danielbernalb/LibreCO2/images/Box 1.jpg

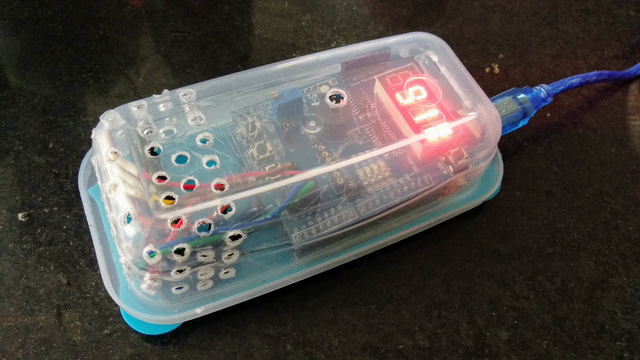
images/Box 1.jpg
