danielbernalb/LibreCO2/images/Sensirion SCD30 connection.jpg

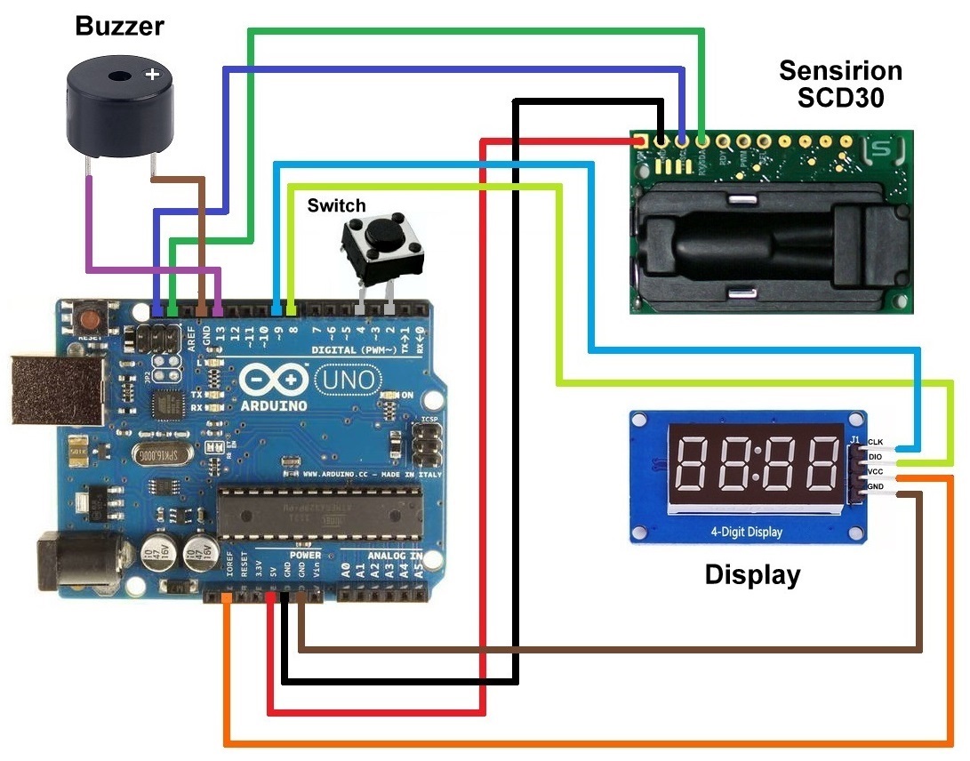
images/Sensirion SCD30 connection.jpg
