danielbernalb/LibreCO2/images/ShieldMF.jpg

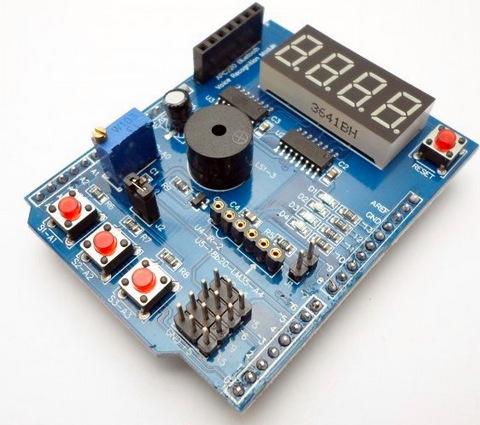
images/ShieldMF.jpg
