danielbernalb/LibreCO2/images/Materiales2.jpg

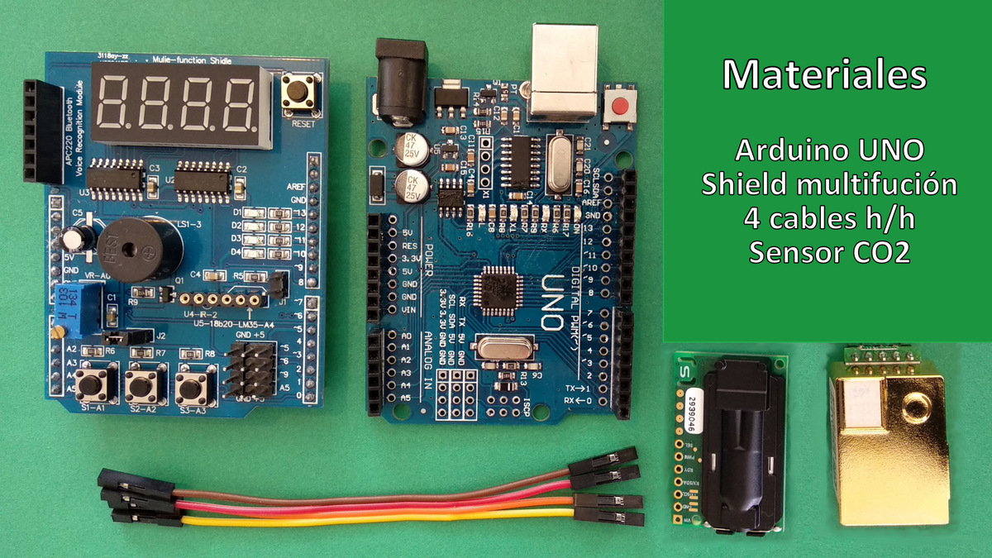
images/Materiales2.jpg
