danielbernalb/LibreCO2/images/Materials all.jpg

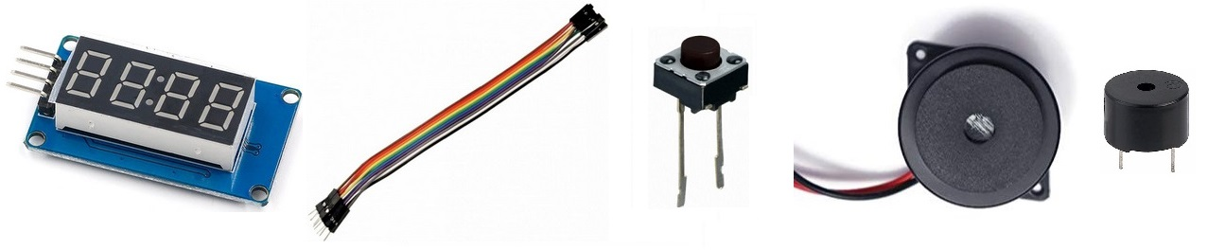
images/Materials all.jpg
