danielbernalb/LibreCO2/INSTRUCCIONES en Español.md

# LibreCO2
LibreCO2: Medidor de CO2 usando Arduino UNO y un sensor de CO2 comercial (SenseAir S8, Sensirion SCD30, Winsen MH-Z14 o MHZ-19 o Cubic CM1106).

Esta es una versión básica de un medidor de CO2 de bajo costo con los materiales más comunes del mercado: Arduino UNO y los 4 sensores de bajo costo de CO2 más populares: SenseAir S8, Sensirion SCD30, Winsen MH-Z14 o 19 y Cubic CM1106. LibreCO2 usa un Arduino UNO, pero puede extenderse al MEGA o nano, por ser muy popular en escuelas y frecuentemente usado en las clases de tecnología o electrónica y la mayoría de escuelas tienen muchos de ellos. 

El código del Arduino es lo más sencillo posible y puede programarse cargando el archivo .hex con el programa Xloader y así no necesitarías instalar el software Arduino para compilar y programar el código. Si buscas un sensor más avanzado y con conectividad por Bluetooth o por Wifi puedes construir un [AireCiudadano](https://github.com/danielbernalb/AireCiudadano) con conectividad Bluetooth y Wifi. LibreCO2 usa los componentes más populares del mercado, así no sean los más avanzados, y el armado más sencillo posible sin necesitar el uso de cautín y soldadura de estaño.

Todos los sensores usados aquí son NDIR que es el estándar actuales para mediciones reales de CO2: 

https://www.co2meter.com/blogs/news/6010192-how-does-an-ndir-co2-sensor-work

Además se ha agregado la compensación de la altura sobre el nivel del mar a la que tomamos la medición.
Es muy importante activar este ajuste por encima de los 1000 metros pues el margen de error sería superior al 11%:

| Altura | Error(%) |
|---|---|
| 0 | 0 |
|  500 | 6 |
|  1000  | 11 |
|  1500  | 16 |
|  2000  | 21 |
|  2500  | 26 |
|  3000  | 30 |
|  3500  | 34 |

# 1. Materiales:

Existen dos opciones para el armado de sensor, la más sencilla es usando un Escudo Multifunción (Shield) de Arduino el cual ya incluye el Display de 4 dígitos, el buzzer y los botones, con lo cual se facilita mucho más el montaje. La segunda armando las partes por individual.

# 1.1. Opción con Escudo multifunción:

Materiales

1. Escudo multifunción (Arduino Shield multifunction).

El Escudo tiene un bug o error que puede cortocircuitarlo con el conector USB, corte los pines que se muestran en la foto y agregue un trozo de cinta al conector USB (que también se muestra en el [video explicativo](https://github.com/danielbernalb/LibreCO2/blob/main/INSTRUCCIONES%20en%20Espa%C3%B1ol.md#video-explicativo):

Cortar pines escudo

Link compra [Aliexpress](https://es.aliexpress.com/wholesale?SearchText=multifunction-arduino-shield), Link compra [Colombia](https://listado.mercadolibre.com.co/arduino-escudo-multi-funcion#D[A:arduino%20escudo%20multi%20funcion]), Compra Latinoamérica: Mercadolibre o tiendas de electrónica.

2. Arduino UNO cualquier versión. Sirve el original Arduino Italiano o las versiones chinas, la diferencia está en la instalación del driver. El que llaman "Original" a la izquierda y la copia o clone a la derecha:

Arduino original & clone

Link compra [Aliexpress](https://es.aliexpress.com/wholesale?catId=0&initiative_id=SB_20210322194538&SearchText=arduino+uno+r3), Link compra [Colombia](https://listado.mercadolibre.com.co/arduino-uno#D[A:arduino%20uno]), Compra Latinoamérica: Mercadolibre o tiendas de electrónica.

3. 4 cables jumper hembra hembra (sirve cualquier tamaño pero es preferible 10 o 15cm).

Link compra [Aliexpress](https://es.aliexpress.com/wholesale?SearchText=jumper-wires), Link compra [Colombia](https://listado.mercadolibre.com.co/arduino-jumper-hembre-hembra#D[A:arduino%20jumper%20hembre%20hembra]), Compra Latinoamérica: Mercadolibre o tiendas de electrónica.

4. Sensor, opciones:

	a. SenseAir S8, el mejor en relación costo/beneficio. Traído desde China por Aliexpress cuesta 28 dólares y desde USA 44 dólares, es el más recomendado y su costo es bajo. Además tiene el referente de ser la misma marca de sensor que usa los populares medidores Aranet 4 de 200 euros de precio (https://kaspars.net/blog/aranet4-teardown).
	
	SenseAir S8
	
	Link desde Aliexpress China:
	https://es.aliexpress.com/item/4000884582128.html
	
	Link desde Digikey USA:
	https://www.digikey.com/es/products/detail/senseair-north-america-inc/004-0-0053/10416532
	
	A favor: excelente precio, muy buen desempeño (aceptable velocidad y fiel), rápido envío desde USA y envío gratis desde China.
	
	En contra: necesita soldadura para conectar los pines o cables. 
	
	b. Sensirion SCD30, el más costoso (52 dólares) pero en nuestras pruebas el de mejor desempeño. Sensirion tiene distribuidores en USA y Europa que envían a Latinoamérica. Ejemplo:
	https://www.mouser.com/ProductDetail/Sensirion/SCD30/?qs=rrS6PyfT74fdywu4FxpYjQ%3D%3D
	
	SCD30 Sensirion
	
	A favor: excelente desempeño (rápido y fiel), rápido envío en USA y Europa y envíos a Latinoamérica.
	
	En contra: necesita soldadura para conectar los pines o cables, alto precio (52 dólares). 
	
	Para la conexión del Arduino al sensor Sensirion se usa el protocolo Modbus ya que este nos permite conectar directamente el Arduino al SCD30 sin necesidad de drivers de datos que complicarían mucho el montaje. Sólo debes conectar el pin SEL al VIN del sensor usando una resistencia de 100 kΩ (kilo ohmnios) como se vé en las fotos y video para habilitar el modo Modbus.

	c. Winsen MH-Z14 o 19, el más barato y popular, buen desempeño, algo lento. Puedes usar cualquie versión de sensor: MH-Z14, MH-Z14A, MH-Z19B o MH-Z19C.b Ten cuidado con las falsas copias del sensor!!!

	Winsen MH-Z14a
	
	A favor: desempeño aceptable (lento comparado al Sensirion, fiabilidad media), bajo costo (18 dolares con envío incluido desde China por Aliexpress).
	
	En contra: tiempo de envío variable con Aliexpress desde China (20 días a mes y medio), falsificaciones (ten cuidado, sólo compra de la tienda Oficial de Aliexpress).

	REPITO: sólo compra el MH-Z19B o MH-Z19C de la tienda de distribución de Winsen en Aliexpress, el mercado está invadido de falsas copias, más información en: https://emariete.com/sensores-co2-mh-z19b-falsos/ o en ingles en: https://youtu.be/5_QQe75-SZI

	Original Winsen MH-Z19b

	Venta de versiones originales en la página del fabricante en Aliexpress:
	https://es.aliexpress.com/item/1005001865093513.html

	d. Cubic CM1106, la última opción porque el distribuidor de China vende sólo unidades recuperadas de segunda mano y de vez en cuando están agotados, son muy baratos y su desempeño es aceptable. 
	https://www.aliexpress.com/item/4001082699057.html
	
	Cubic CM1106
	
****************************

**Conexiones para cada sensor:**

PIN del Escudo ---> Sensor

**SenseAir S8 sensor**

GND ---> G0 Pin 2 de la regleta de 4 pines

+5 &nbsp; ---> G+ Pin 1 de la regleta de 4 pines

5 &nbsp; &nbsp; ---> Pin 2 de la regleta de 5 pines

6 &nbsp; &nbsp; ---> Pin 3 de la regleta de 5 pines

SenseAir S8

****************************

**Sensor Sensirion SCD30**

GND ---> GND

+5 &nbsp;  ---> VIN

5 &nbsp; &nbsp; ---> RX/SDA

6 &nbsp; &nbsp; ---> TX/SCL

SCD30 connection

****************************
**Sensor Winsen MH-Z19B o 19C**

GND ---> GND

+5 &nbsp; ---> VIN

5 &nbsp; &nbsp; ---> RX

6 &nbsp; &nbsp; ---> TX

MH-Z19B connection

****************************
**Sensor Winsen MH-Z14 o MH-Z14A**

GND ---> Pin 5 or 16 del conector

+5 &nbsp; ---> Pin 4 o 17 del conector

5 &nbsp; &nbsp; ---> Pin 3 o 18 del conector

6 &nbsp; &nbsp; ---> Pin 2 o 19 del conector

MH-Z14A connection	

****************************
**Sensor Cubic CM1106**

GND ---> G Pin 2 de la regleta de 4 pines

+5 &nbsp; ---> V1 Pin 1 de la regleta de 4 pines

5 &nbsp; &nbsp; ---> R Pin 2 de la regleta de 5 pines

6 &nbsp; &nbsp; ---> T Pin 3 de la regleta de 5 pines

Cubic CM1106

## Video explicativo:

(http://www.youtube.com/watch?v=KYHC06xhUu4 "VideoLibreCO2")

# 1.2. Opción por partes individuales:

1. Arduino UNO original o versión china.
2. Display TM1687.
3. Jumper hembra - macho.
4. Uno o dos Pulsadores o cables (uno para la calibración, otro para el nivel de Beep).
5. Opcional: Buzzer.

Materiales

6. Sensor, iguales opciones que la opción con Escudo multifunción.

****************************

**Conexiones para todos los sensores:**

Componente electrónico ---> PIN del Arduino

**Display---> PIN Arduino**

CLK    ---> 9

DIO    ---> 8

VCC    ---> IOREF en la versión original o 5V en la copia china

GND    ---> GND

**Buzzer**

"+"    ---> 11

otro  ---> GND

**Pulsador de calibración**

Cualquiera ---> A0

Cualquiera ---> A2

**Pulsador de nivel del Beep**

Cualquiera ---> A3

Cualquiera ---> A5

**Pulsador de altura sobre el nivel del mar**

Cualquiera ---> 2

Cualquiera ---> 4

****************************
**SenseAir S8**

VIN Pin 1 de regleta de 4 pines ---> 5V 

GND Pin 2 de regleta de 4 pines ---> GND

RX Pin 2 de regleta de 5 pines ---> 6

TX Pin 3 de regleta de 5 pines ---> 7 

SenseAir S8 connection

****************************
**Sensor Sensirion SCD30**

VIN    ---> 3.3V 

GND    ---> GND

TX/SCL ---> 7

RX/SDA ---> 6

SEL    ---> 3.3V

SCD30 connection

****************************
**Winsen MH-Z19B sensor**

VIN Pin 1 de regleta de 4 pines ---> 5V 

GND Pin 2 de regleta de 4 pines ---> GND

RX Pin 2 de regleta de 5 pines ---> 6

TX Pin 3 de regleta de 5 pines ---> 7 

MH-Z19B connection

****************************
**Winsen MH-Z14A sensor**

Pin 2 o 19 del conector ---> 6

Pin 3 o 18 del conector ---> 7

Pin 4 o 17 del conector ---> 5V

Pin 5 or 16 del conector ---> GND 

MH-Z14A connection	

****************************
**Cubic CM1106 sensor**

V1 Pin 1 de la regleta de 4 pines ---> 5V 

G Pin 2 de la regleta de 4 pines ---> GND

R Pin 2 de la regleta de 5 pines ---> 6

T Pin 3 de la regleta de 5 pines ---> 7 

Cubic CM1106

****************************
# 2. Programar el Firmware (código en el Arduino)

Existen 3 opciones para programar el Arduino: la más sencilla es usar un teléfono Android y un cable USB OTG, la siguiente es usar un PC con el software Xloader y la última instalando Arduino en un PC.

**1. Teléfono Android.**

USB OTG cable

 - Conecta el cable USB OTG al teléfono.
 - Instala la app de Android ["Arduino Hex Uploader-Firmware Bin Upload"](https://play.google.com/store/apps/details?id=xyz.vidieukhien.embedded.arduinohexupload&hl=en_US&gl=US).
 - Baja el archivo .hex file de este ["Directorio de Google drive"](https://drive.google.com/drive/folders/1FxXLVhaGF6UCVObQlh8cVLddyWyQqUT0) basado en la versión de tu sensor (Shield y marca de sensor). Encuentra el archivo .hex que vas cargar en el Arduino, cada versión de sensor (Sensirion, Winsen or Cubic) se encuentra disponible el el directorio "hex files". Ejemplo: "LibreCO2_MFShield_SCD30.hex" es el arhivo para el sensor Sensirion con el Shield Multifunción. Nota: No descargues el archivo .hex directamente de la página con la opción "Salvar como", que daña el archivo. Usa solamente el enlace de Google Drive.
 - Busca el archivo .hex en tú teléfono.
 - Sube el código a tu tarjeta Arduino.
 - FIN.

Video de programación de el Firmware:

(http://www.youtube.com/watch?v=_87qzZFMgwg "LibreCO2")

Link compra Cable OTG USB [Aliexpress](https://es.aliexpress.com/wholesale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), Link compra [Colombia](https://listado.mercadolibre.com.co/cable-otg#D[A:cable%20otg]), Compra Latinoamérica: Mercadolibre o tiendas de electrónica.

**2. Usando tu PC con el software Xloader (sólo Windows):**

1. Conecta el Arduino a tu computador y espera a que el driver se instale automáticamente. Si el driver no se instala automáticamente debes identificar si tu Arduino es original o una copia:

1.1. Si el Arduino es original, instala el paquete Arduino con drivers: https://www.arduino.cc/en/Guide/ArduinoUno

1.2. Si el Arduino es copia china sigue las instrucciones de esta página web: https://learn.sparkfun.com/tutorials/how-to-install-ch340-drivers

2. Después de instalado el driver, tienes 2 opciones:

2.1. Si lo único que quieres es programar el Arduino desde Windows sin tener que ver el código y compilarlo, usa el software Xloader que se encuentra en la carpeta del mismo nombre:

Xloader

A la izquierda se muestra la ventana del Xloader cuando se inicia.

2.1.1. Explora hasta encontrar el achivo .hex que vas a cargar en el Arduino. Cada versión de sensor (Sensirion, Winsen o Cubic) se encuentra disponible en el directorio "hex files". Ejemplo: "LibreCO2_Shield_SCD30.hex" es el archivo para el sensor Sensirion SCD30 con el uso del Escudo Multifunción (Shield). No lo descargues directamente de la página con la opción "Guardar como", eso arruina el archivo.  Usa el siguiente enlace de Google Drive para bajar el archivo .hex buscando tu versión de Sensor (SCD30, MHZ14_9 o CM1106) y construcción (con Shield o por Partes):
 
https://drive.google.com/drive/folders/1FxXLVhaGF6UCVObQlh8cVLddyWyQqUT0

2.1.2. Selecciona la tarjeta Arduino que estas usando (Uno/ATmega328).

2.1.3. Selecciona el puerto de comunicaciones COM al que está conectado el Arduino, si no lo sabes buscalo en el Admnistrador de dispositivos "Puertos COM y LPT".

2.1.4. Selecciona la velocidad Baud rate a 115200.

2.1.5. Presiona el botón “Upload”.

2.1.6. Cuando el archivo .hex file se carga en el Arduino, foto a la derecha, sale el mensaje de "xxxxx bytes uploaded", si falla te saldrá el mensaje de "upload fails".

**3. Si quieres editar y compilar el código instala el software Arduino en Windows, Mac o Linux:**
  
  https://www.arduino.cc/en/software
  
  La siguiente guía explica como instalar Arduino en Windows, Mac o Linux y es muy completa:
  https://learn.sparkfun.com/tutorials/installing-arduino-ide/all  
  
  En Youtube existen cientos de tutoriales para instalar Arduino en diferentes sistemas operativos y aprender su programación, además puedes colaborar mejorando este código o crear tu propia versión.  
  
 # 3. Caja para el sensor.
 
Opciones iniciando por la más sencilla y económica:

3.1. Caja comercial de bajo costo.

Busca una caja plástica con un ancho similar al del Arduino y un largo mayor para que en el espacio sobrante ubiques el sensor. En el espacio sobrante perfora varios huecos por dónde entre aire para el mismo, en mi caso los hice con destornillador de 4mm. Haz otro hueco para el Buzzer, para el cable USB y el adaptador y listo. Ejemplo:

Caja1

Cuando quieras usar el teclado para la calibración o la programación del BEEP, abre la caja y accede al teclado para luego volver a cerrala.
Puedes acomodar cajas plásticas de diferentes tamaños, en el siguiente caso se usa una espuma debajo porque la caja es más alta, además se hacen 3 huecos de un tamaño mediano (7mm) para los 3 botones y asó poder acceder desde afuera a los botones sin necesidad de abrir la caja:

Caja2

3.2. Caja en madera MDF usando corte láser. En desarrollo.

3.3. Caja en PLA con impresora 3D. En desarrollo.
  
 # 4. Funcionamiento del sensor.
 
 Cuando se haya realizado la programación del Arduino tenemos varios modos y opciones de funcionamiento del sensor:
 
 1. Modo normal: Al encender el sensor aparece el aviso BEEP y un número entre 700 y 1300 que muestra el nivel de la alarma que tenemos programado. En el numeral 3 se explicará cómo modificarlo. Luego de ello el medidor verifica la conexión al sensor de bajo costo. Si aparece el mensaje "good" la conexión está bien hecha y se continuará con el proceso de calentamiento del sensor ("heat") que dura 30 segundos para los sensores Sensirion y Cubic, y 3 minutos para los Winsen. Si el mensaje es "fail" la conexión ha fallado y debemos verificar la conexión entre el Arduino y el sensor. Después de el calentamiento el valor de CO2 en partes por millón ppm, aparece en pantalla. Cuando el valor es superior al nivel Beep la alarma suena y los leds del escudo titilan.

 2. CALI Modo Calibración: [Explicado en el video anexo](#video-explicativo).
La calibración del sensor se recomienda después de armado el sensor y cuando se aprecien mediciones muy diferentes al aire libre del rango estimado de 400 ppm. Todos estos sensores de bajo costo se calibran al aire libre, colocándolos en un espacio exterior por unos minutos sin que reciban viento fuerte pues esto afecta la medición, por ello se recomienda colocarlos dentro de una caja que evite el viento directo.
Luego de cumplir con estas condiciones, debes presionar el botón S1-A1 (CALI) en la versión con escudo, o el "switch" en la versión por partes, durante más de 5 segundos, y aparecerá en pantalla el mensaje "cal-" y comenzando un conteo regresivo de 5 minutos para el Sensirion y Cubic y 20 minutos para el Winsen.
Al finalizar este tiempo el sensor recibe la orden de calibración y queda listo para usarse de nuevo. Si quieres interrumpir el proceso de calibración presiona el botón S2-A2 (BEEP).

3. BEEP Modo cambio de nivel del umbral de alarma: [Explicado en el video anexo](#video-explicativo).
Para cambiar el nivel de la alarma de 1000 ppm, por defecto, a otro valor entre 700 y 1400 ppm o para apagarlo OFF debes presionar el botón S2-A2 (BEEP) en la versión con escudo, o colocar un cable o switch adicional del pin A3 a A5 en la versión por partes, durante más de 5 segundos y aparecerá el mensaje "BEEP" y luego el valor al que esta programado. Luego debes presionar de nuevo el botón para modificar el valor, cuando lo encuentres presiona el botón S3-A3 (ALTI) para programar este nuevo valor de nivel del BEEP. Aparecerá el mensaje "done" confirmando el ingreso correcto del valor.

4. ALTI Modo cambio del valor de altura sobre el nivel del mar:
Para cambiar el valor de la altura sobre el nivel del mar del lugar en que nos encontramos debes presionar el botón S3-A3 (ALTI) en la versión con escudo, o colocar un cable o switch adicional del pin A0 a A2 en la versión por partes, durante más de 5 segundos y aparecerá el mensaje "ALTI" y luego el valor que tiene programado. Luego debes presionar de nuevo o mantener el botón presionado aumentar el valor o presionar el botón S2 - A2 (BEEP) para disminur, cuando encuentres el valor correcto presiona el botón S1-A1 (CALI) para programar este nuevo valor de nivel de ALTI. Aparecerá el mensaje "done" confirmando el ingreso correcto del valor.

****************************
### Contacto

Si tienes alguna duda, bug, aporte o comentario escríbeme al correo electrónico danielbernalb@gmail.com o la cuenta de twitter [@danielbernalb](https://twitter.com/danielbernalb) 
Más información en la página web: ["Aire ciudadano"](https://aireciudadano.com/)

****************************

### Otros proyectos abiertos recomendados de sensores de CO2 o que incluyen sensores de CO2:

- [AireCiudadano](https://github.com/danielbernalb/AireCiudadano).
- [Codos](https://github.com/miguelangelcasanova/codos).
- [Anaire](https://github.com/anaireorg/anaire-devices).
- [eMariete](https://emariete.com/en/home-co2-meter/).
- [Medición de CO2](http://www.jorgealiaga.com.ar/?page_id=2864).
- Canairio en la web
