danielbernalb/LibreCO2/(commit log)

2021-02-10 Rotuine sensor connection test and minor changes
2021-02-12 Button rouitne reviewed and delays
2021-02-15 Pin changes
2021-02-15 Pin changes and sensor init routine
2021-02-24 Correction in Calibration CRC
2021-02-25 Push button routine, more cleanups
2021-02-27 Change in Preheat and Calibration routine
2021-03-04 All sensors in one code
2021-03-04 Support for all 3 sensors and connection detection
2021-03-04 All sensors in one code, new Beep level option
2021-08-23 Altitude compensation rouitnes
    Altitude compensation rouitnes:
    1. For SCD30 the sensor have the compensation, the code put the value in the register
    2. For SenseAir, Cubic and Winsen the compensation is make by software with the value of the altitude.
2021-08-26 English guide updated to new sensors and options
